Jlhaynes/TemperatureController/Software/MyGadgeteerModules/TemperatureProbe/TemperatureProbe/Image.jpg

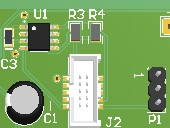
Software/MyGadgeteerModules/TemperatureProbe/TemperatureProbe/Image.jpg
