Jlhaynes/TemperatureController/Software/MyGadgeteerModules/ControlRelays/ControlRelays/Image.jpg

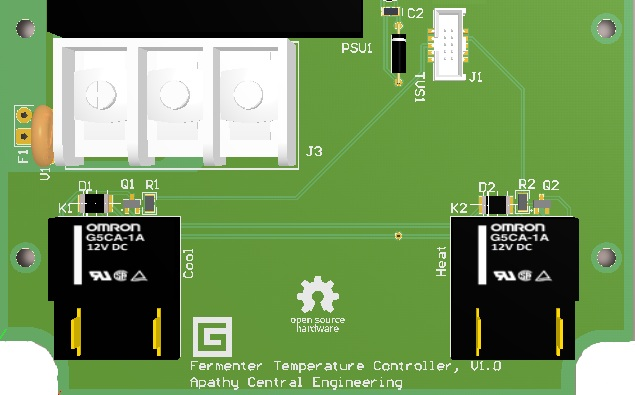
Software/MyGadgeteerModules/ControlRelays/ControlRelays/Image.jpg
