Jlhaynes/TemperatureController/Software/TemperatureController/TemperatureController/Resources/StartScreen.jpg

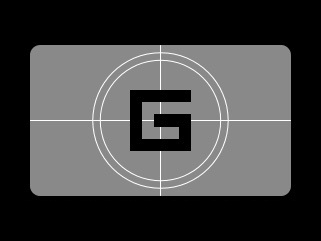
Software/TemperatureController/TemperatureController/Resources/StartScreen.jpg
