Jlhaynes/TemperatureController/Hardware/Parts Library/CUI.png

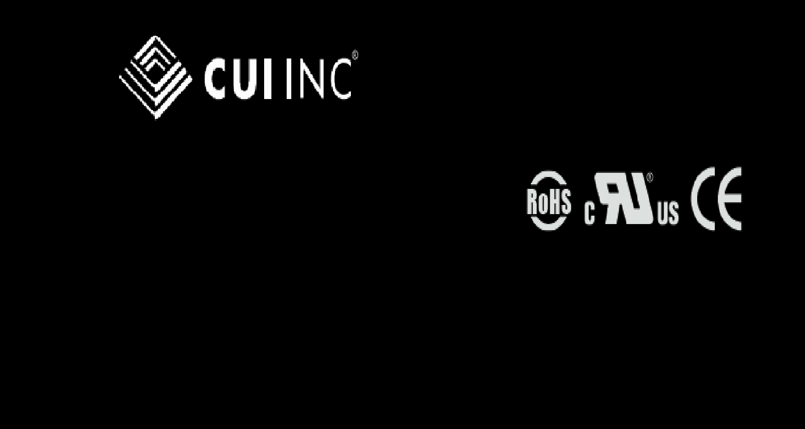
Hardware/Parts Library/CUI.png
