Jlhaynes/TemperatureController/Hardware/Parts Library/OmronRelayTexture.bmp

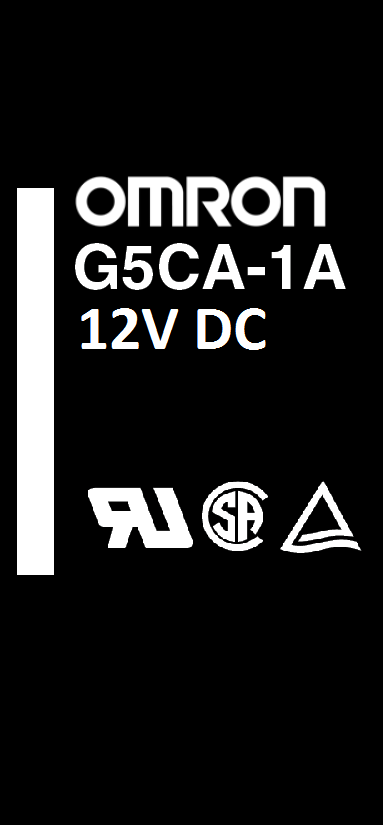
Hardware/Parts Library/OmronRelayTexture.bmp
