Jlhaynes/TemperatureController/Hardware/Parts Library/OmronRelayTexture.jpg

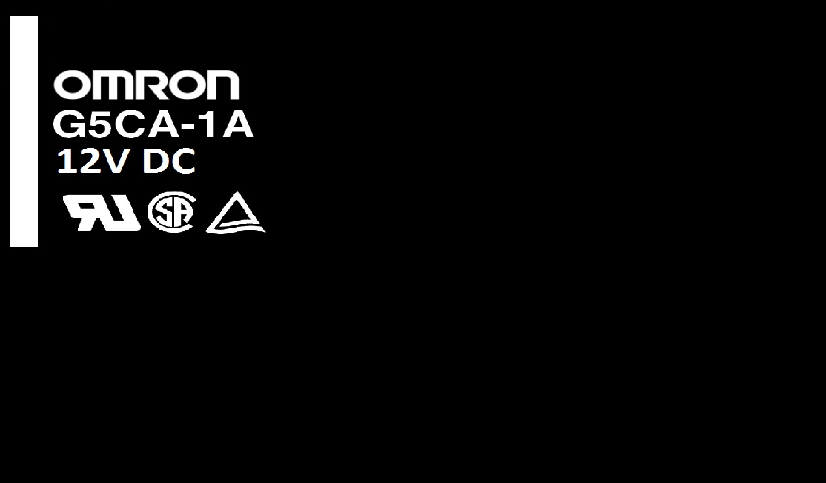
Hardware/Parts Library/OmronRelayTexture.jpg
