Jlhaynes/TemperatureController/Hardware/TemperatureControllerPCB/TemperatureController.pdf

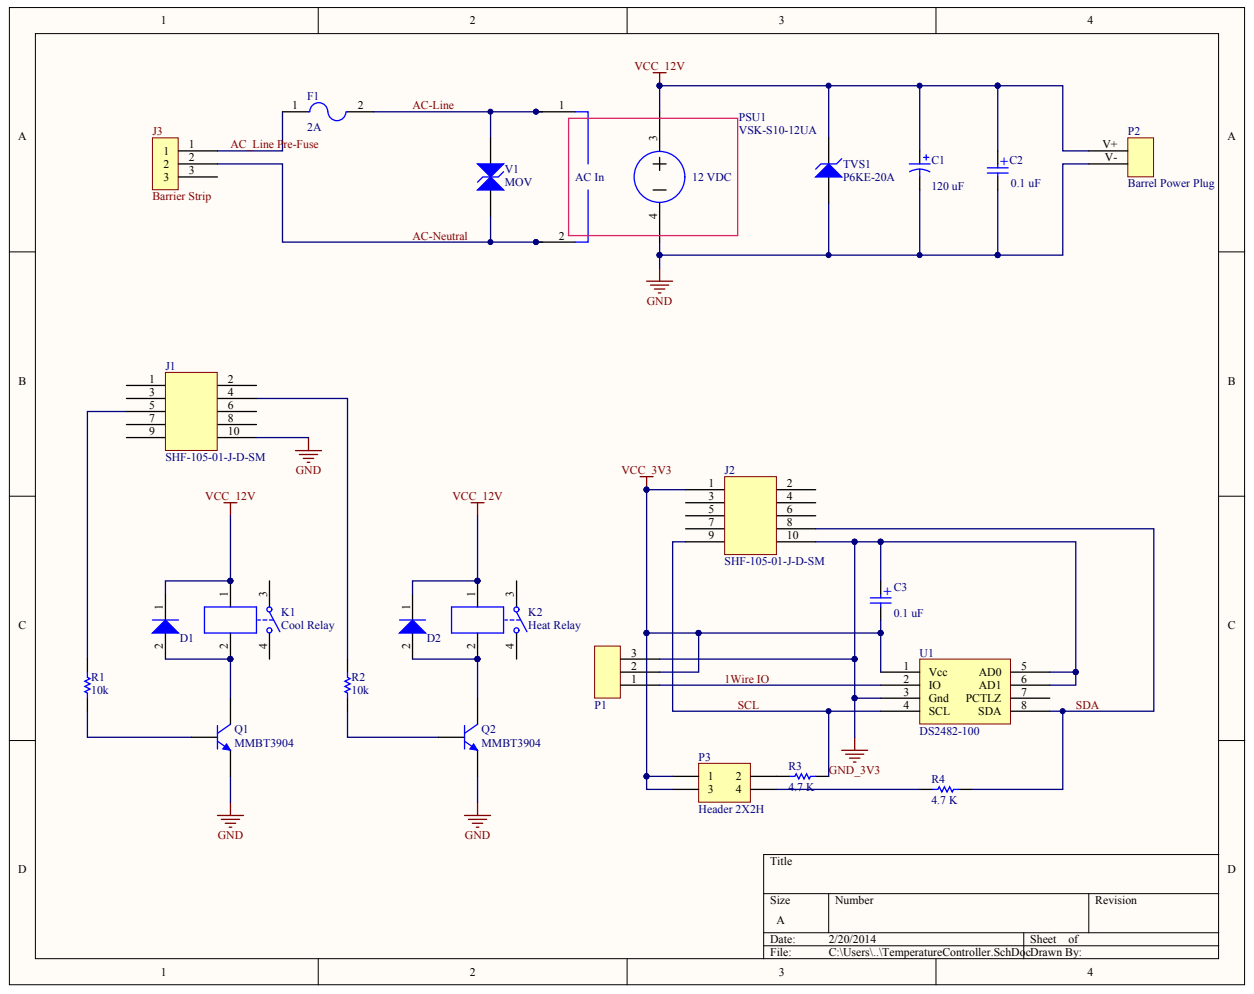
[picture p26: page 1]

9 | 10

1 | IO 2 PCTLZ

Gnd 3 | 7

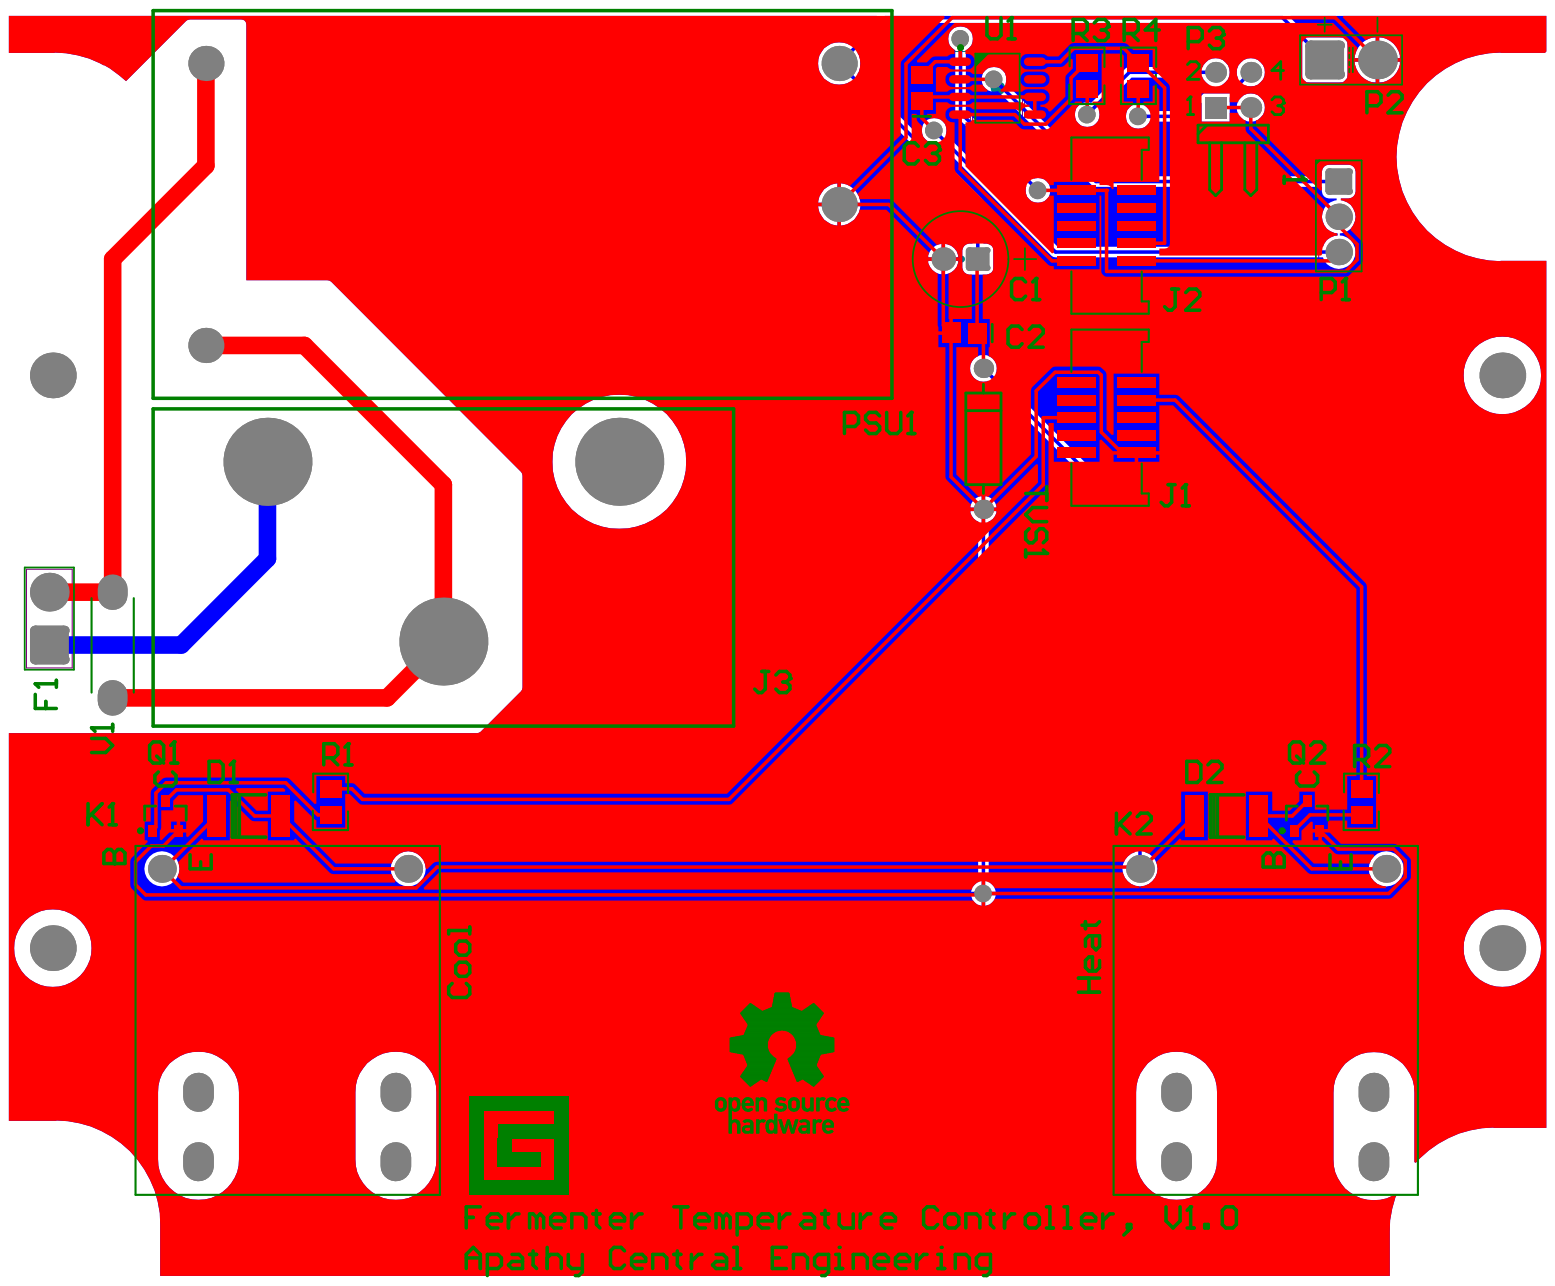
[picture p27: page 2]

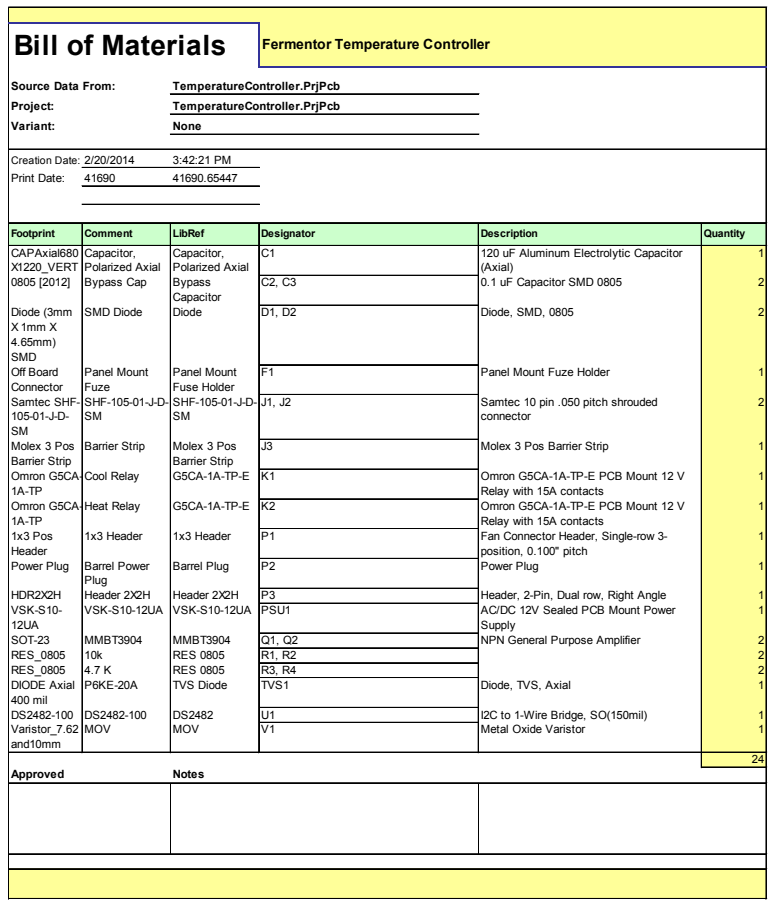
[picture p28: page 3]

Footprint | Comment | LibRef | Designator | Description | Quantity
