Jlhaynes/TemperatureController/(list of files, drawings)

Other design files:
Hardware/Parts Library/Capacitors.SchLib
Hardware/Parts Library/Circuit Protection.SchLib
Hardware/Parts Library/Connectors.SchLib
Hardware/Parts Library/Diodes.SchLib
Hardware/Parts Library/IntegratedCircuits.SchLib
Hardware/Parts Library/Part Footprints.PcbLib
Hardware/Parts Library/PowerSupplys.SchLib
Hardware/Parts Library/Relays.SchLib
Hardware/Parts Library/Resistors.SchLib
Hardware/Parts Library/Transistors.SchLib
Hardware/TemperatureControllerPCB/TemperatureController.PcbDoc
Hardware/TemperatureControllerPCB/TemperatureController.PrjPcb
Hardware/TemperatureControllerPCB/TemperatureController.SchDoc
